explosion33/IREC/README.md

# DomeCracker
This project implements an STM32 based flight computer with an onboard sensor suite. It features a custom PCB and embedded firmware to handle encoder reading, sensor interface and data logging in flight.
