explosion33/IREC/Flight_Computer/README.md

# RCS_Hardware
SARP 2023 RCS Flight Controller KiCAD project

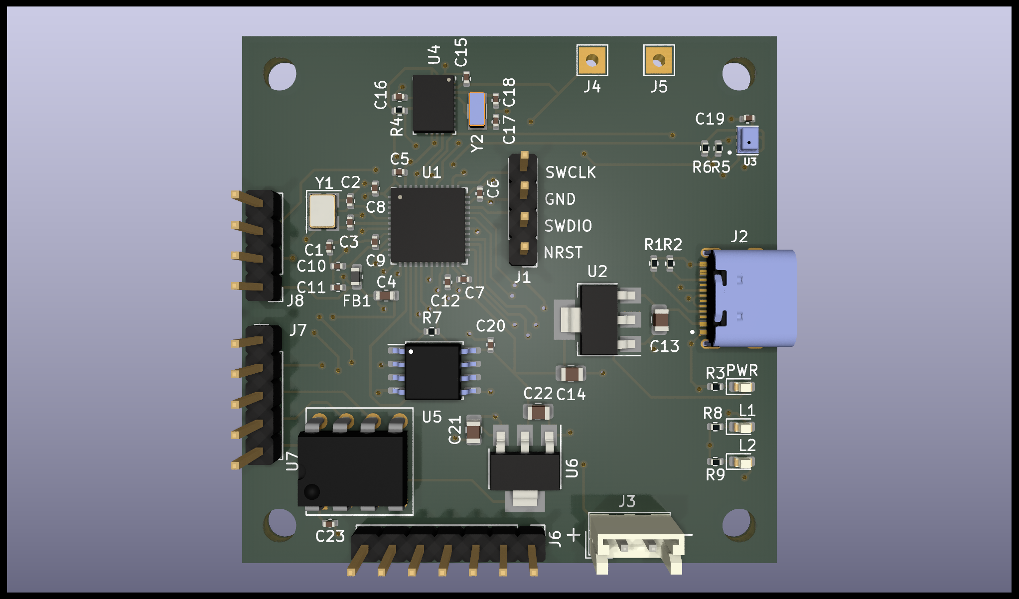
[picture p1: Flight_Computer/render.png]
BOARD RENDER


# Components
* STM32F401CCU6
* BNO055
* BMP280
* LIS2HH12 (TODO)
* W25Q32JVXX
* USB-C
* Battery Connector
