explosion33/IREC/Flight_Computer/Components/BMP280/adafruit_products_BMP280_sch.png

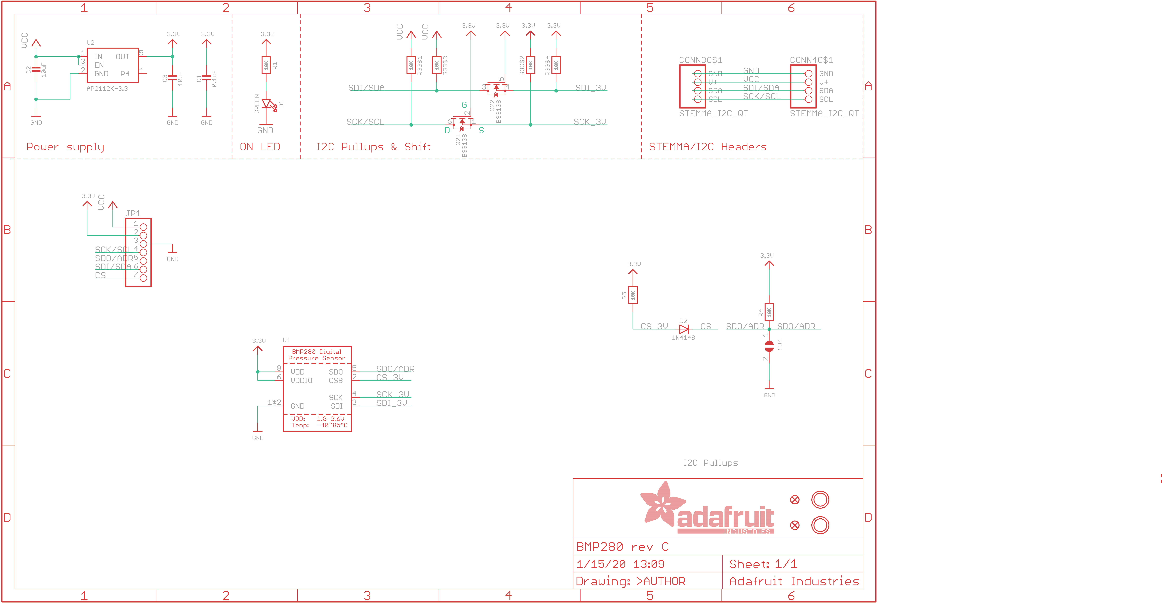
Flight_Computer/Components/BMP280/adafruit_products_BMP280_sch.png
