explosion33/IREC/Flight_Computer/Components/32_768_Crystal/32_768_crystal.STEP

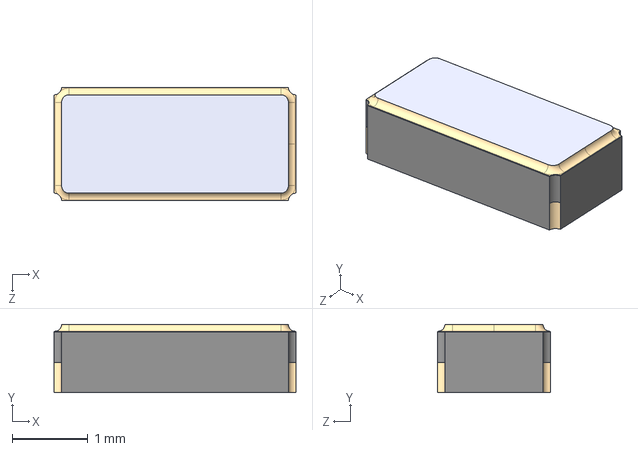
[picture p3: CAD file, 2024-08-07]
Flight_Computer/Components/32_768_Crystal/32_768_crystal.STEP
3.20 x 0.9 x 1.50 mm
