explosion33/IREC/Flight_Computer/Components/BMP280/BMP280.step

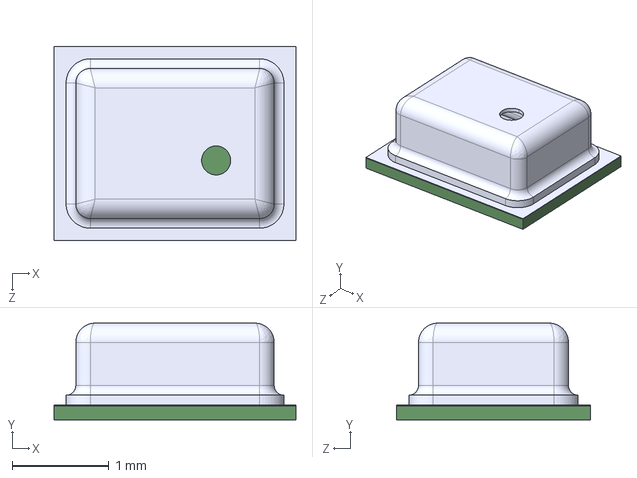
[picture p4: CAD file, 2024-08-07]
Flight_Computer/Components/BMP280/BMP280.step
2.50 x 1.00 x 2.00 mm
