explosion33/IREC/Flight_Computer/Components/BNO055/BNO055.step

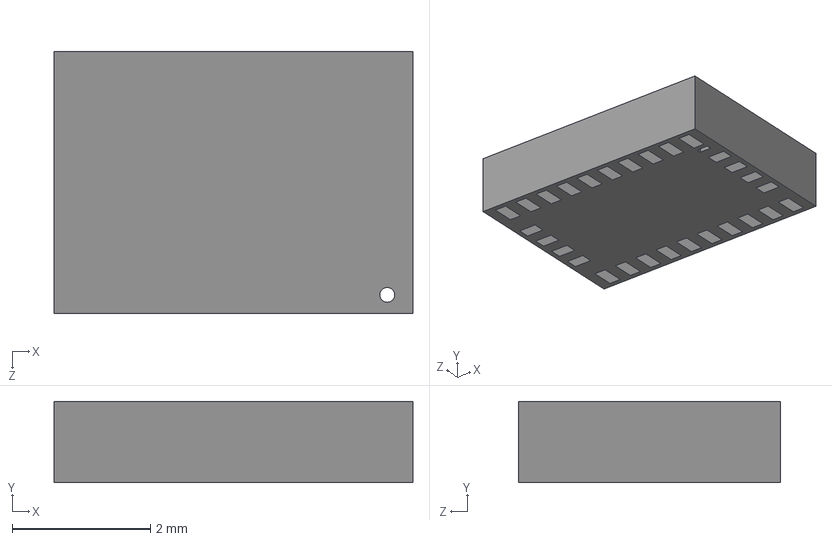
[picture p5: CAD file, 2024-08-07]
Flight_Computer/Components/BNO055/BNO055.step
5.20 x 1.18 x 3.80 mm
