explosion33/IREC/Flight_Computer/Components/LT1690/LTC1690IN8#PBF.STEP

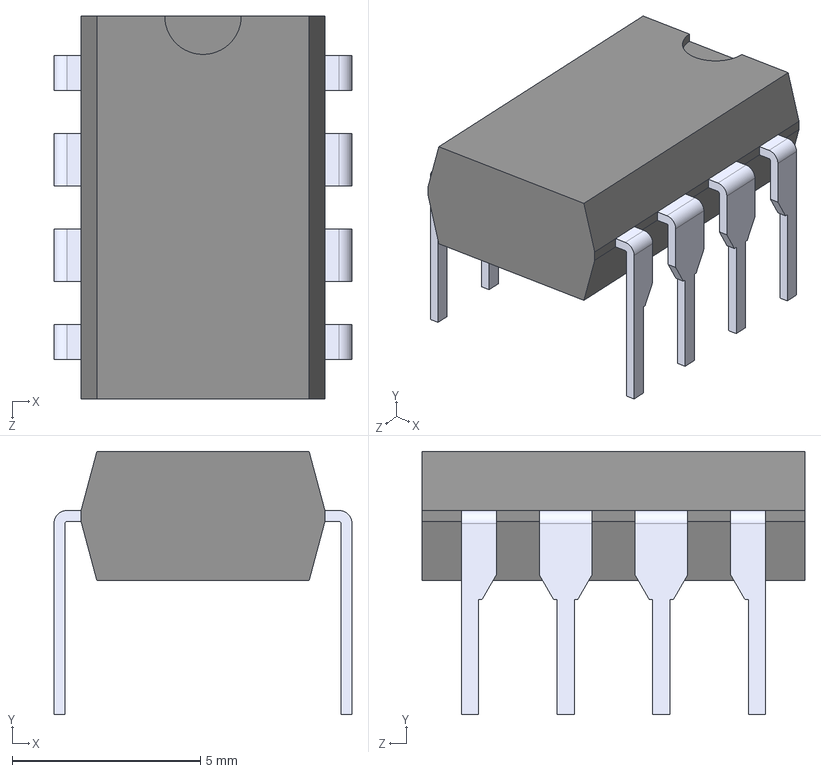
[picture p6: CAD file, 2024-08-07]
Flight_Computer/Components/LT1690/LTC1690IN8#PBF.STEP
7.91 x 6.98 x 10.2 mm
