explosion33/IREC/Flight_Computer/Components/USBC/TYPE-C-31-M-12.step

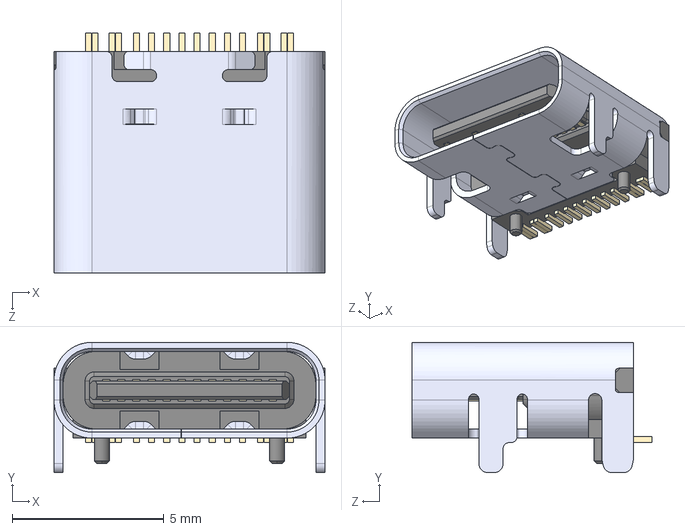
[picture p7: CAD file, 2024-08-07]
Flight_Computer/Components/USBC/TYPE-C-31-M-12.step
8.94 x 4.30 x 7.90 mm
