explosion33/IREC/Flight_Computer/Components/W25Q32/W25Q32JVSSIQ--3DModel-STEP-269445.STEP

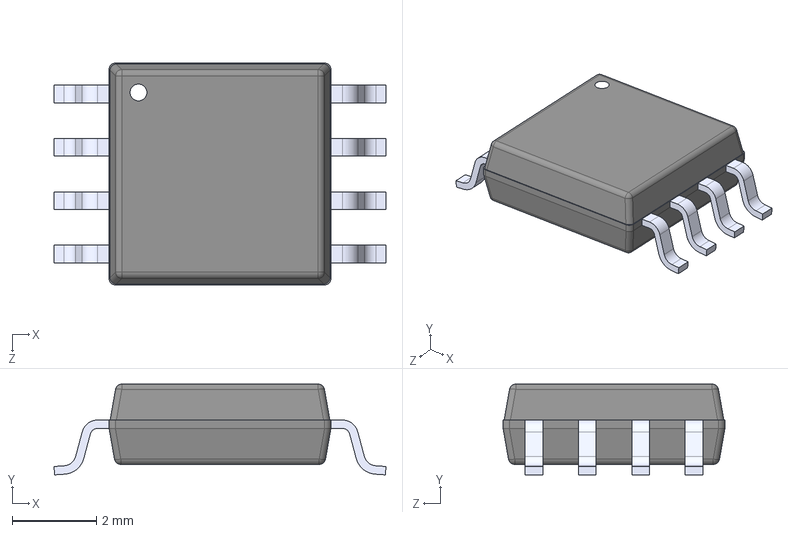
[picture p8: CAD file, 2024-08-07]
Flight_Computer/Components/W25Q32/W25Q32JVSSIQ--3DModel-STEP-269445.STEP
7.90 x 2.16 x 5.28 mm
