explosion33/IREC/Flight_Computer/PCB_Outline_2x_Scaled.dxf

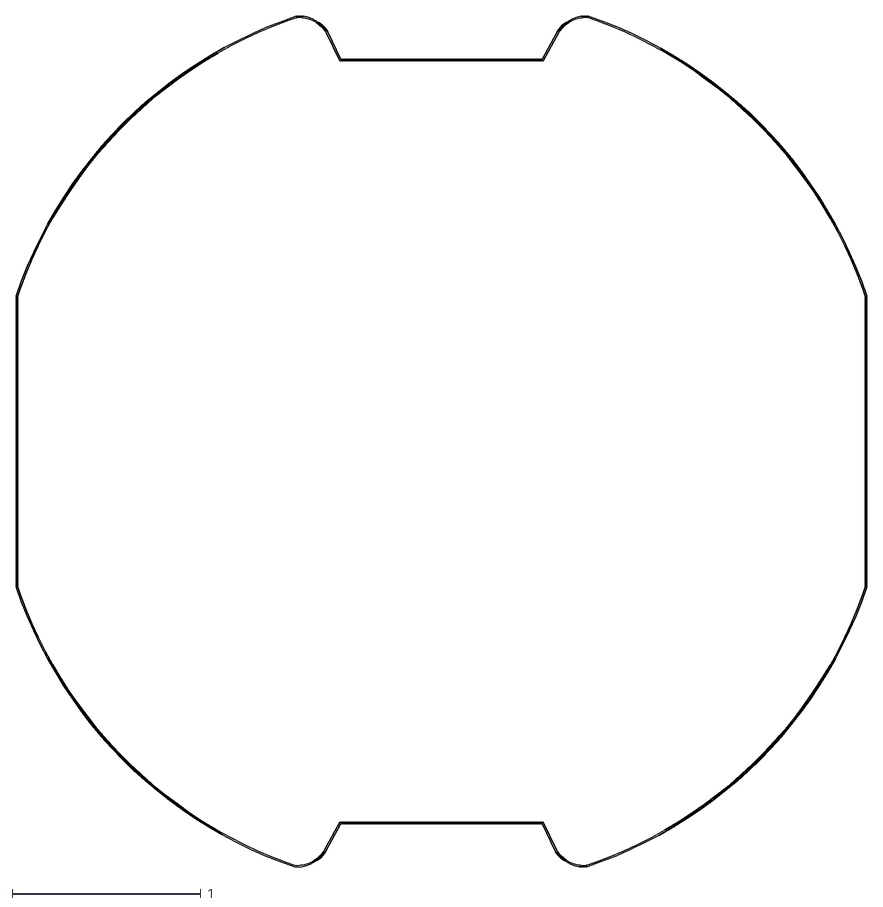
[picture p9: CAD file, 2025-02-13]
Flight_Computer/PCB_Outline_2x_Scaled.dxf
4.51 x 4.51
