explosion33/IREC/Flight_Computer/Components/LT1690/DIP-8 N.step

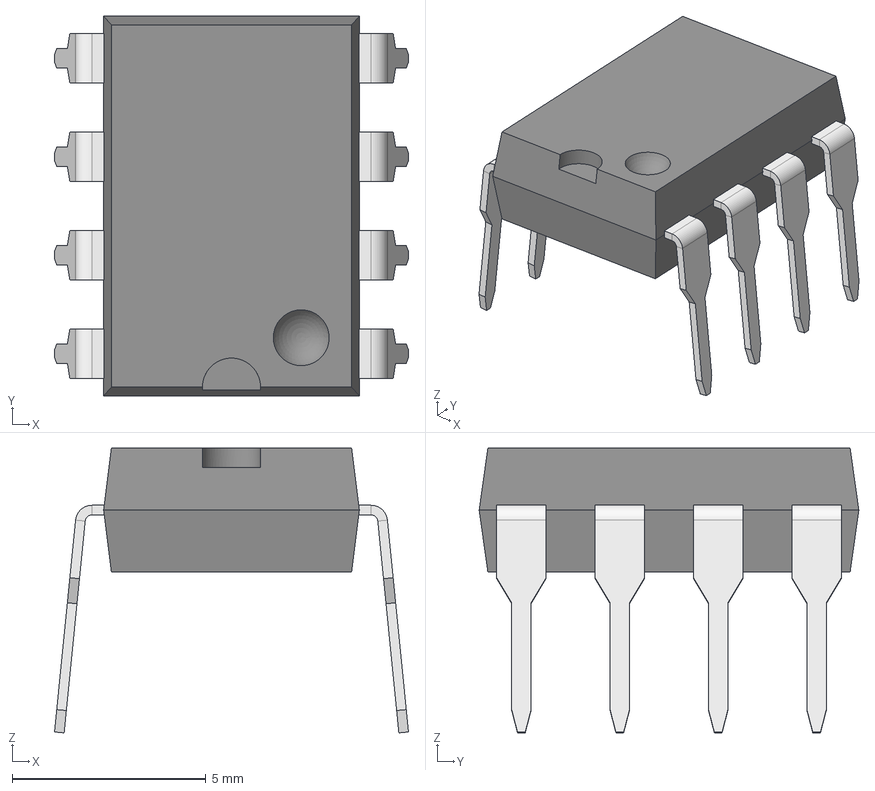
[picture p10: CAD file, 2024-08-07]
Flight_Computer/Components/LT1690/DIP-8 N.step
9.14 x 9.80 x 7.35 mm
