explosion33/IREC/Flight_Computer/fc.kicad_pcb

## KiCad design Flight_Computer/fc.kicad_pcb (2025-04-15)

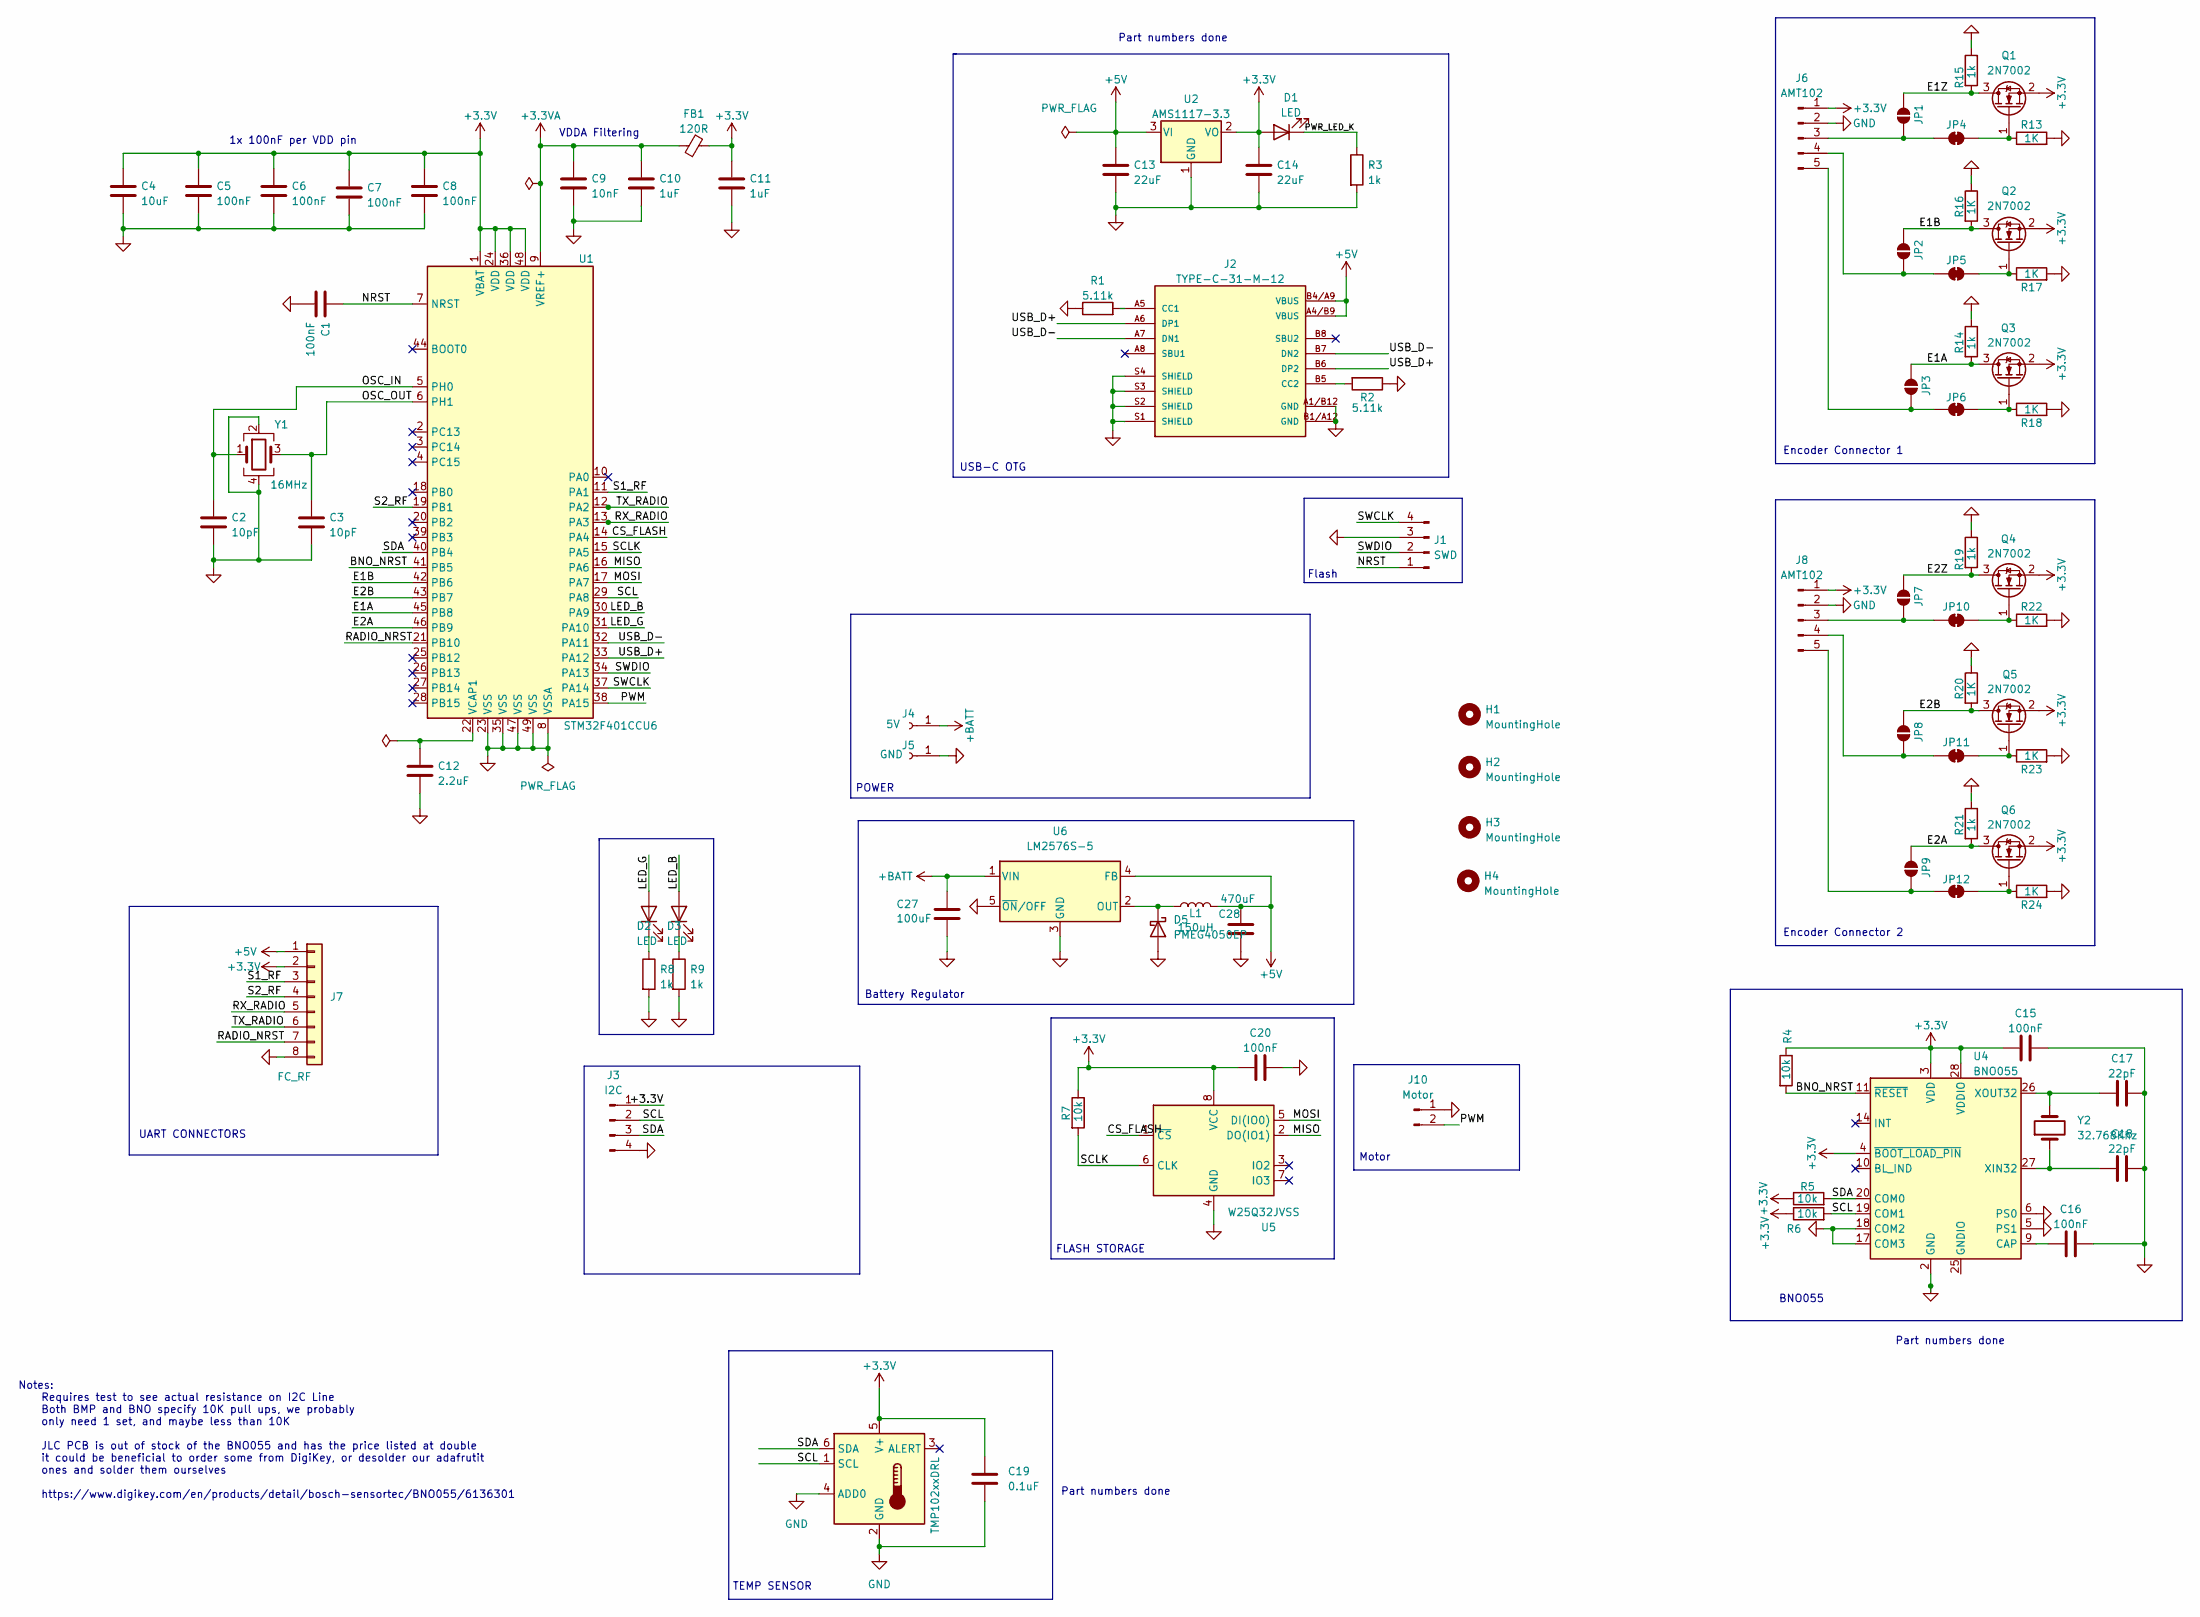
[picture p11: schematic fc.kicad_sch]

Parts:
C1, C5, C6, C7, C8, C15, C16, C20: 100nF; C_0402_1005Metric; JLCPCB# C307331
C2: 10pF; C_0402_1005Metric; JLCPCB# C32949
C3: 10pF; C_0402_1005Metric; LCSC Part C1525
C4: 10uF; C_0402_1005Metric; JLCPCB# C19702
C9: 10nF; C_0402_1005Metric; JLCPCB# C15195
C10, C11: 1uF; C_0402_1005Metric; JLCPCB# C52923
C12: 2.2uF; C_0402_1005Metric; JLCPCB# C12530
C13, C14: 22uF; C_0805_2012Metric; JLCPCB# C5674
C17, C18: 22pF; C_0402_1005Metric; JLCPCB# C466226
C19: 0.1uF; C_0402_1005Metric
C27: 100uF; C_0805_2012Metric; LCSC Part C141660
C28: 470uF; CP_Elec_10x10.5; LCSC Part C189257
D1, D2, D3: LED; LED_0603_1608Metric; JLCPCB# C273598
D5: PMEG4050EP; D_SOD-128
FB1: 120R; L_0603_1608Metric; JLCPCB# C85831
H1, H2, H3, H4: MountingHole; MountingHole_3.2mm_M3
J1: SWD; PinHeader_1x04_P2.54mm_Vertical
J2: TYPE-C-31-M-12; HRO_TYPE-C-31-M-12; PARTREV 2020.12.08; JLCPCB# C165948
J3: I2C; PinHeader_1x04_P2.54mm_Vertical
J4: 5V; TestPoint_THTPad_2.5x2.5mm_Drill1.2mm
J5: GND; TestPoint_THTPad_2.5x2.5mm_Drill1.2mm
J6, J8: AMT102; JST_SH_SM05B-SRSS-TB_1x05-1MP_P1.00mm_Horizontal
J7: FC_RF; Molex_200528-0080_1x08-1MP_P1.00mm_Horizontal; LCSC Part C505273
J10: Motor; JST_SH_SM02B-SRSS-TB_1x02-1MP_P1.00mm_Horizontal
JP1, JP2, JP3, JP7, JP8, JP9: SolderJumper_2_Open; SolderJumper-2_P1.3mm_Open_RoundedPad1.0x1.5mm
JP4, JP5, JP6, JP10, JP11, JP12: SolderJumper_2_Bridged; SolderJumper-2_P1.3mm_Bridged_RoundedPad1.0x1.5mm
L1: 150uH; L_TaiTech_TMPC1265_13.5x12.5mm; LCSC Part C408533
Q1, Q2, Q3, Q4, Q5, Q6: 2N7002; SOT-23; LCSC Part C466660
R1, R2: 5.11k; R_0402_1005Metric; JLCPCB# C25906
R3, R8, R9: 1k; R_0402_1005Metric; JLCPCB# C11702
R4, R5, R6, R7: 10k; R_0402_1005Metric; JLCPCB# C60490
R13, R16, R17, R18, R20, R22, R23, R24: 1K; R_0402_1005Metric
R14, R15, R19, R21: 1k; R_0402_1005Metric; LCSC Part C102758
U1: STM32F401CCU6; QFN-48-1EP_7x7mm_P0.5mm_EP5.6x5.6mm; JLCPCB# C79861
U2: AMS1117-3.3; SOT-223-3_TabPin2; JLCPCB# C6186
U3: TMP102xxDRL; SOT-563
U4: BNO055; LGA-28_5.2x3.8mm_P0.5mm; JLCPCB# C93216
U5: W25Q32JVSS; SOIC-8_5.23x5.23mm_P1.27mm; JLCPCB# C82344
U6: LM2576S-5; TO-263-5_TabPin3
Y1: 16MHz; Crystal_SMD_3225-4Pin_3.2x2.5mm; JLCPCB# C13738
Y2: 32.768Khz; Crystal_SMD_3215-2Pin_3.2x1.5mm; JLCPCB# C907540

Connections:
+3.3V: C4.1, C5.1, C6.1, C7.1, C8.1, C11.1, C14.1, C15.1, C19.1, C20.1, D1.2 (A), FB1.2, J3.1, J6.1, J7.2, J8.1, Q1.2 (S), Q2.2 (S), Q3.2 (S), Q4.2 (S), Q5.2 (S), Q6.2 (S), R4.1, R5.1, R6.1, R7.1, U1.1 (VBAT), U1.24 (VDD), U1.36 (VDD), U1.48 (VDD), U2.2 (VO), U3.5 (V+), U4.3 (VDD), U4.4 (~BOOT_LOAD_PIN), U4.28 (VDDIO), U5.8 (VCC)
+3.3VA: C9.1, C10.1, FB1.1, U1.9 (VREF+)
+5V: C13.1, C28.2, J2.A4/B9 (VBUS), J2.B4/A9 (VBUS), J7.1, L1.2, U2.3 (VI), U6.4 (FB)
+BATT: C27.2, J4.1, U6.1 (VIN)
/BNO_NRST: R4.2, U1.41 (PB5), U4.11 (~RESET)
/CS_FLASH: U1.14 (PA4), U5.1 (~CS)
/E1A: JP3.2 (B), Q3.3 (D), R14.2, U1.45 (PB8)
/E1B: JP2.2 (B), Q2.3 (D), R16.2, U1.42 (PB6)
/E1Z: JP1.2 (B), Q1.3 (D), R15.2
/E2A: JP9.2 (B), Q6.3 (D), R21.2, U1.46 (PB9)
/E2B: JP8.2 (B), Q5.3 (D), R20.2, U1.43 (PB7)
/E2Z: JP7.2 (B), Q4.3 (D), R19.2
/LED_B: D3.2 (A), U1.30 (PA9)
/LED_G: D2.2 (A), U1.31 (PA10)
/MISO: U1.16 (PA6), U5.2 (DO(IO1))
/MOSI: U1.17 (PA7), U5.5 (DI(IO0))
/NRST: C1.1, J1.1, U1.7 (NRST)
/OSC_IN: C2.1, U1.5 (PH0), Y1.1
/OSC_OUT: C3.1, U1.6 (PH1), Y1.3
/PWM: J10.2, U1.38 (PA15)
/PWR_LED_K: D1.1 (K), R3.1
/RADIO_NRST: J7.7, U1.21 (PB10)
/RX_RADIO: J7.5, U1.13 (PA3)
/S1_RF: J7.3, U1.11 (PA1)
/S2_RF: J7.4, U1.19 (PB1)
/SCL: J3.2, R6.2, U1.29 (PA8), U3.1 (SCL), U4.19 (COM1)
/SCLK: R7.2, U1.15 (PA5), U5.6 (CLK)
/SDA: J3.3, R5.2, U1.40 (PB4), U3.6 (SDA), U4.20 (COM0)
/SWCLK: J1.4, U1.37 (PA14)
/SWDIO: J1.2, U1.34 (PA13)
/TX_RADIO: J7.6, U1.12 (PA2)
/USB_D+: J2.A6 (DP1), J2.B6 (DP2), U1.33 (PA12)
/USB_D-: J2.A7 (DN1), J2.B7 (DN2), U1.32 (PA11)
GND: C1.2, C2.2, C3.2, C4.2, C5.2, C6.2, C7.2, C8.2, C9.2, C10.2, C11.2, C12.2, C13.2, C14.2, C15.2, C16.2, C17.2, C18.2, C19.2, C20.2, C27.1, C28.1, D5.2 (A), J1.3, J2.A1/B12 (GND), J2.B1/A12 (GND), J2.S1 (SHIELD), J2.S2 (SHIELD), J2.S3 (SHIELD), J2.S4 (SHIELD), J3.4, J5.1, J6.2, J7.8, J8.2, J10.1, R1.1, R2.1, R3.2, R8.2, R9.2, R13.2, R14.1, R15.1, R16.1, R17.2, R18.2, R19.1, R20.1, R21.1, R22.2, R23.2, R24.2, U1.8 (VSSA), U1.23 (VSS), U1.35 (VSS), U1.47 (VSS), U1.49 (VSS), U2.1 (GND), U3.2 (GND), U3.4 (ADD0), U4.2 (GND), U4.5 (PS1), U4.6 (PS0), U4.17 (COM3), U4.18 (COM2), U5.4 (GND), U6.3 (GND), U6.5 (~ON/OFF), Y1.2, Y1.4
unnamed: D2.1 (K), R8.1
unnamed: D3.1 (K), R9.1
unnamed: D5.1 (K), L1.1, U6.2 (OUT)
unnamed: J2.A5 (CC1), R1.2
unnamed: J2.B5 (CC2), R2.2
unnamed: J6.3, JP1.1 (A), JP4.1 (A)
unnamed: J6.4, JP2.1 (A), JP5.1 (A)
unnamed: J6.5, JP3.1 (A), JP6.1 (A)
unnamed: J8.3, JP7.1 (A), JP10.1 (A)
unnamed: J8.4, JP8.1 (A), JP11.1 (A)
unnamed: J8.5, JP9.1 (A), JP12.1 (A)
unnamed: JP4.2 (B), Q1.1 (G), R13.1
unnamed: JP5.2 (B), Q2.1 (G), R17.1
unnamed: JP6.2 (B), Q3.1 (G), R18.1
unnamed: JP10.2 (B), Q4.1 (G), R22.1
unnamed: JP11.2 (B), Q5.1 (G), R23.1
unnamed: JP12.2 (B), Q6.1 (G), R24.1
unnamed: C12.1, U1.22 (VCAP1)
unnamed: C16.1, U4.9 (CAP)
unnamed: U4.15 (GNDIO), U4.16 (GNDIO), U4.25 (GNDIO)
unnamed: C18.1, U4.27 (XIN32), Y2.1
unnamed: C17.1, U4.26 (XOUT32), Y2.2

Notes on the sheet:
Part numbers done
VDDA Filtering
Flash
FLASH STORAGE
Encoder Connector 1
UART CONNECTORS
Part numbers done
Motor
1x 100nF per VDD pin
Notes: Requires test to see actual resistance on I2C Line Both BMP and BNO specify 10K pull ups, we probably only need 1 set, and maybe less than 10K JLC PCB is out of stock of the BNO055 and has the price listed at double it could be beneficial to order some from DigiKey, or desolder our adafrutit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
USB-C OTG
TEMP SENSOR
Encoder Connector 2
Battery Regulator
BNO055
POWER

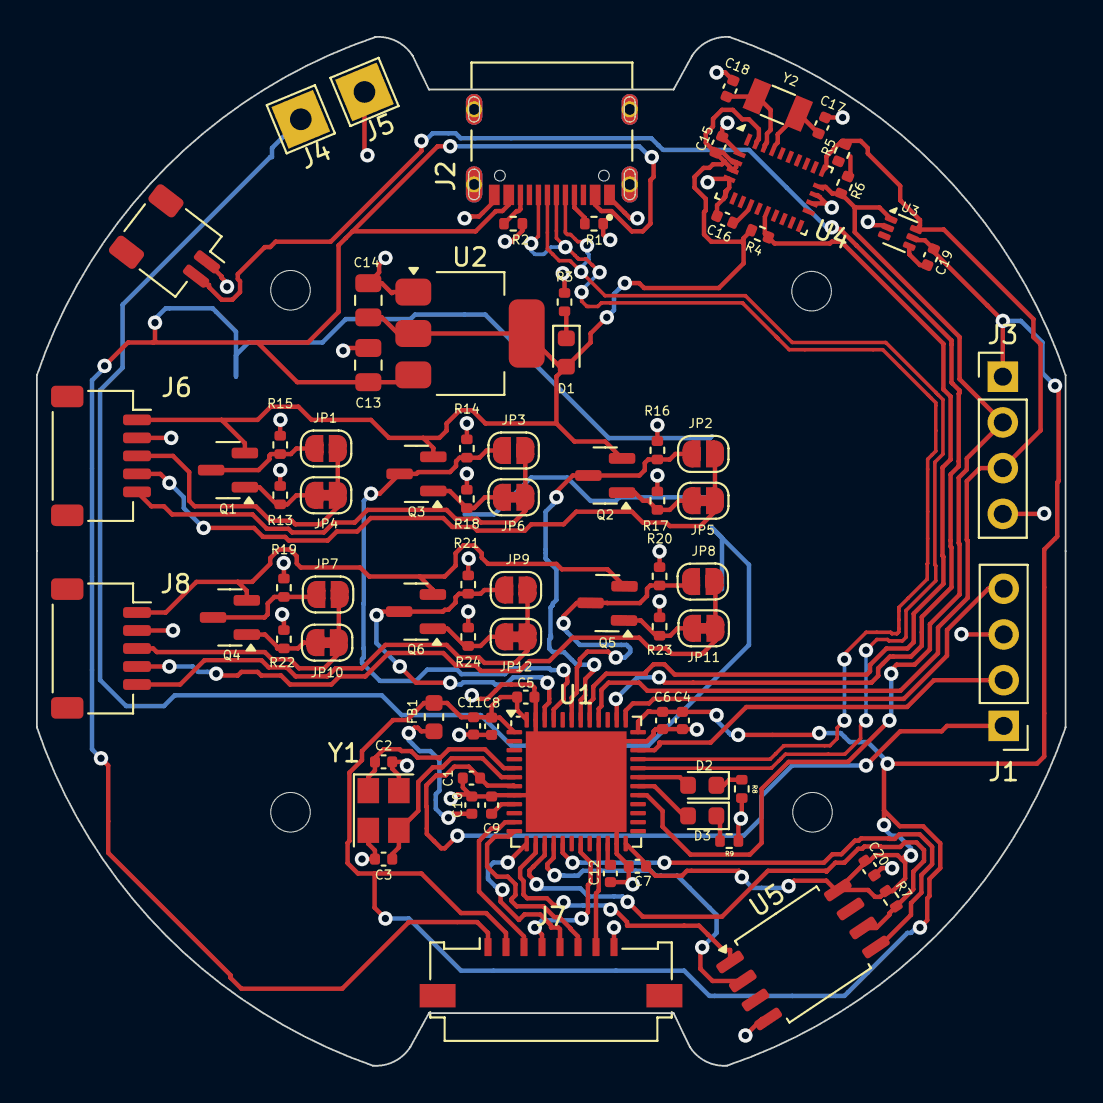
[picture p12: board fc.kicad_pcb from above]

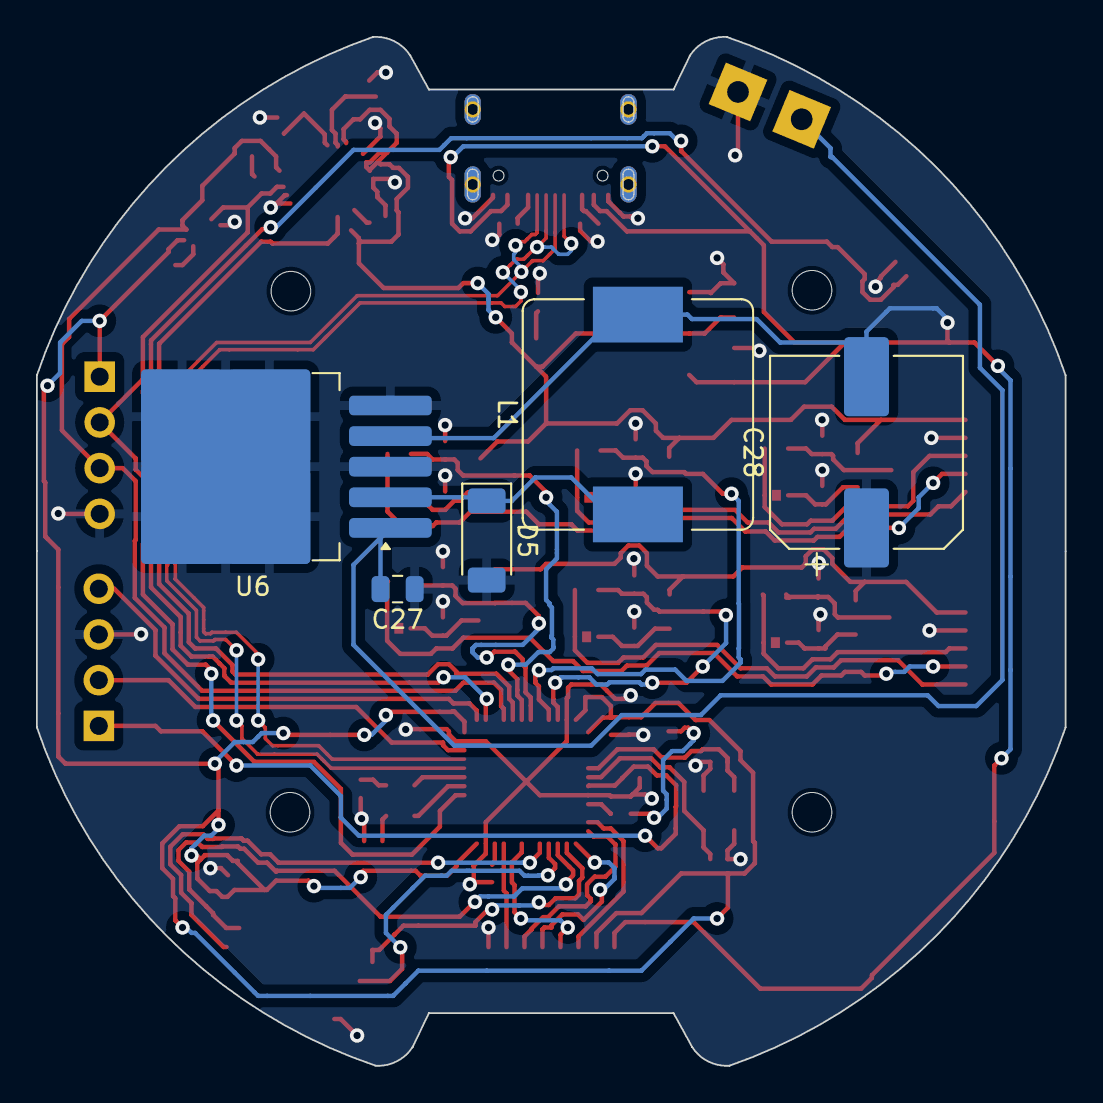
[picture p13: board fc.kicad_pcb from below]

Board: 2 copper layers, 57.2 x 57.2 mm, 88 parts (5 on the bottom side), 56 nets.
