explosion33/IREC/(commit log)

2024-08-07 Copied flight computer over
    [32_768_crystal.STEP, BMP280.step, BNO055.step, DIP-8 N.step, LTC1690IN8#PBF.STEP, RCS_Hardware.csv, RCS_Hardware.kicad_pcb, RCS_Hardware.kicad_sch]
2024-08-21 Add pull up resistor
    [RCS_Hardware.kicad_sch]
2024-09-24 Pull old files
    [RCS_Hardware.kicad_sch]
2024-09-24 Added rotary encoder symbol and schematic
    [RCS_Hardware.kicad_sch]
2024-10-09 Added Uart and LM2576
    [RCS_Hardware.kicad_sch]
2024-10-10 Added AS5601 and motor conn
    [ESC.kicad_pcb, ESC.kicad_sch, RCS_Hardware.kicad_sch]
2024-10-10 Motor connector
    [RCS_Hardware.kicad_sch]
2024-10-17 Added new to do
    [RCS_Hardware.kicad_sch]
2024-10-20 New battery circuit, updated encoders
    [RCS_Hardware.kicad_sch]
2024-10-20 Level shifters
    [RCS_Hardware.kicad_sch]
2024-10-20 Fixed encoders
    [RCS_Hardware.kicad_sch]
2024-10-23 Plus BATT
    [RCS_Hardware.kicad_sch]
2024-10-23 Moved some stuff around
    [RCS_Hardware.kicad_sch]
2024-10-30 Encoder code
2024-11-07 Fixed encoder reading code
    [encoder.py]
2025-01-23 Fixing I2C functionality
2025-01-24 Fixed i2c stuff
2025-01-24 Fixed Write function
    [bno055_map.csv]
2025-01-25 Added calibration functions
2025-01-26 Created folders for encoder, tmp, flash
    [RCS_Hardware.kicad_sch]
2025-01-29 temperature functions
2025-02-06 motor drivers
2025-02-10 updated gyroscope schematic
    [RCS_Hardware.kicad_sch]
2025-02-11 placed components on gyroscope PCB
    [RCS_Hardware.kicad_pcb, RCS_Hardware.kicad_sch]
2025-02-11 moved usb-c connector position
    [RCS_Hardware.kicad_pcb]
2025-02-12 routed most of pcb and updated encoder level-shifting circuit
    [PCB_Outline_2x_Scaled.dxf, RCS_Hardware-Edge_Cuts.dxf, RCS_Hardware.kicad_pcb, RCS_Hardware.kicad_sch]
2025-02-20 Fixed motor tests
2025-02-25 updated encoder and motor connectors
    [RCS_Hardware.kicad_sch]
2025-02-27 updated gyro schematic and started placing PCB
    [RCS_Hardware.kicad_pcb, RCS_Hardware.kicad_sch]
2025-02-28 finished (preliminary) placing of gyro pcb components
    [RCS_Hardware.kicad_pcb, RCS_Hardware.kicad_sch]
2025-03-06 Encoder with I2C
2025-03-11 New encoder method
2025-04-02 Added motor class
2025-04-02 Clean up code
    [bno055_map.csv]
2025-04-02 Deleted ESC
    [ESC.kicad_pcb, ESC.kicad_sch]
2025-04-14 routed pcb
    [RCS_Hardware.kicad_pcb, RCS_Hardware.kicad_sch]
2025-04-15 added part numbers for some footprints on pcb
    [RCS_Hardware.kicad_pcb, RCS_Hardware.kicad_sch]
2025-04-22 Encoder fixes
2025-05-02 Added threads
2025-05-06 Added motor thread
2025-05-14 Optimizing for sensor rate
2025-05-18 PCB Working
2025-05-23 Added led thread
2025-05-29 Fixed motor code
2025-05-29 Fixed motor class
2025-06-11 timeout, disable motor
2025-06-12 Cleaned Up files
    [RCS_Hardware-Edge_Cuts.dxf, fc.csv, fc.kicad_pcb, fc.kicad_sch, rcs_circuit_diagram.kicad_pcb]
